ninopereira/skeleton/pcb/DF_mp3_player/Screenshot from 2026-10-21 17-03-53.png

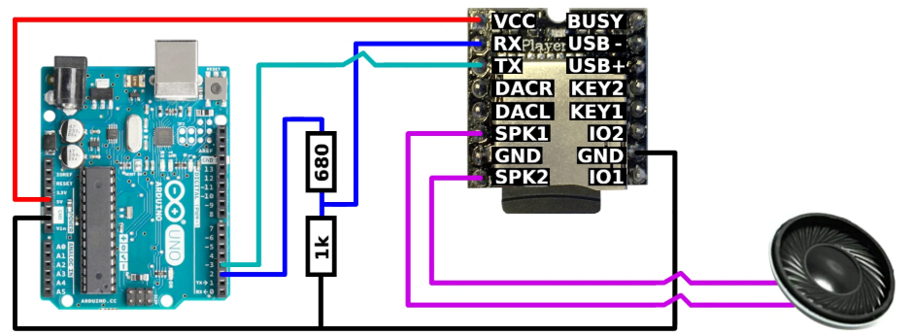
pcb/DF_mp3_player/Screenshot from 2026-10-21 17-03-53.png
