ninopereira/skeleton/docs/DFPlayer_pcb.png

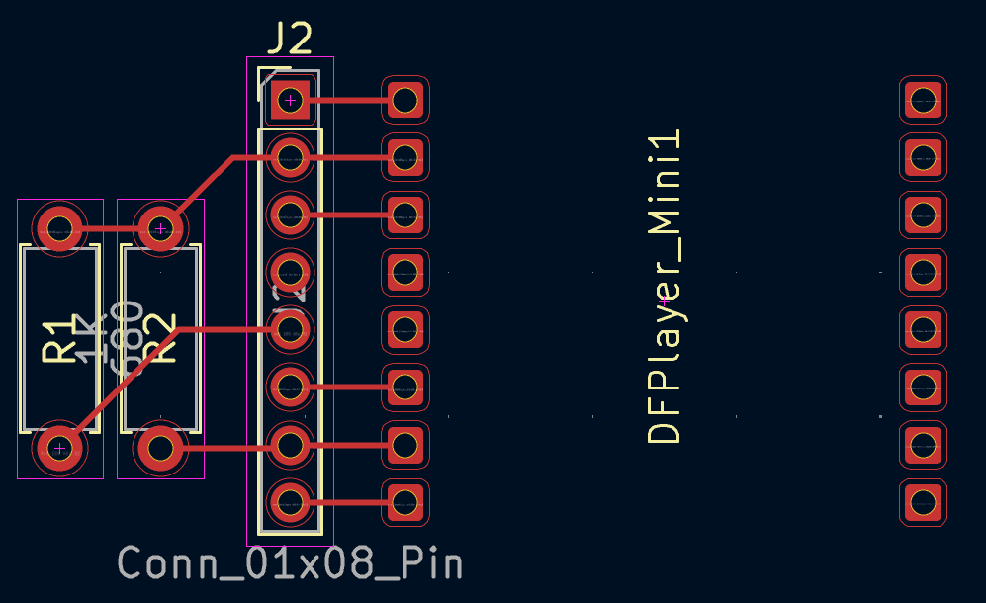
docs/DFPlayer_pcb.png
