ninopereira/skeleton/docs/DFPlayer_schematics.png

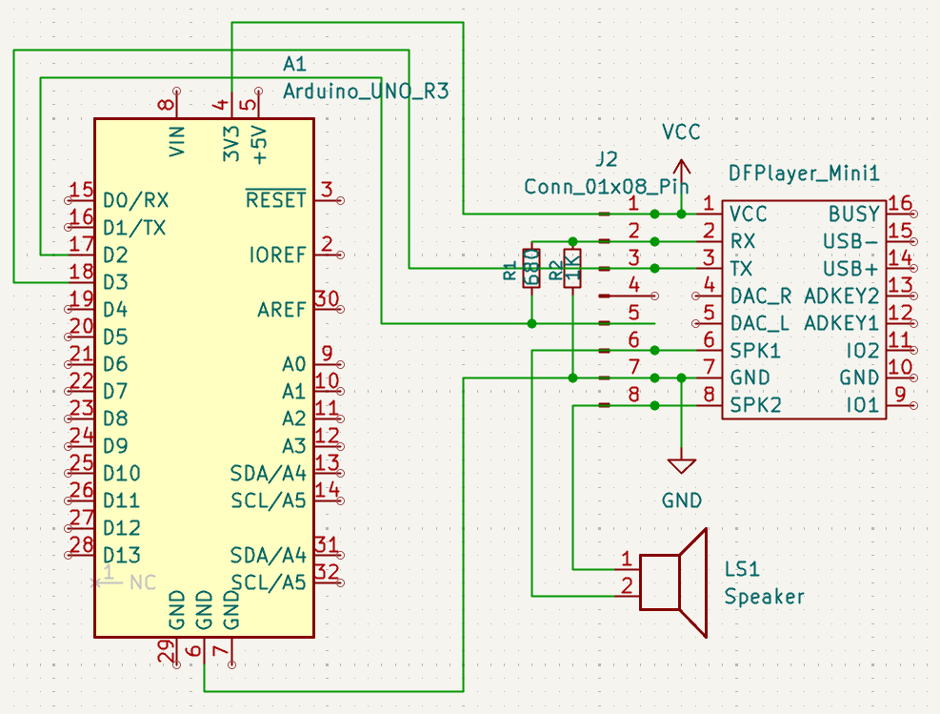
docs/DFPlayer_schematics.png
