ninopereira/skeleton/pcb/DF_mp3_player/Screenshot from 2026-10-21 22-46-34.png

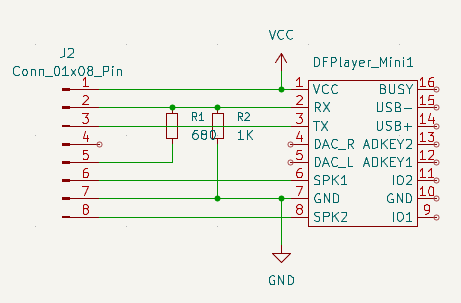
pcb/DF_mp3_player/Screenshot from 2026-10-21 22-46-34.png
