ninopereira/skeleton/pcb/DF_mp3_player/DF_mp3_player.kicad_pcb

## KiCad design pcb/DF_mp3_player/DF_mp3_player.kicad_pcb (2026-10-22)

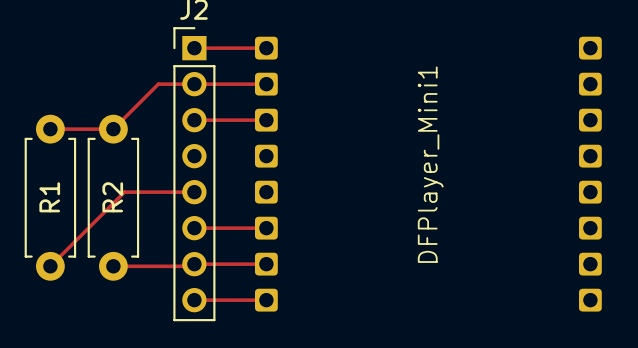
[picture p5: board DF_mp3_player.kicad_pcb from above]

Board: 2 copper layers, 4 parts (0 on the bottom side), 7 nets.

Parts:
DFPlayer_Mini1: DFPlayer_Mini
J2: Conn_01x08_Pin; PinHeader_1x08_P2.00mm_Vertical
R1: 680; R_Axial_DIN0207_L6.3mm_D2.5mm_P7.62mm_Horizontal
R2: 1K; R_Axial_DIN0207_L6.3mm_D2.5mm_P7.62mm_Horizontal

Connections:
GND: DFPlayer_Mini1.7 (GND), J2.7, R2.2
unnamed: DFPlayer_Mini1.2 (RX), J2.2, R1.2, R2.1
unnamed: DFPlayer_Mini1.6 (SPK1), J2.6
unnamed: DFPlayer_Mini1.8 (SPK2), J2.8
unnamed: DFPlayer_Mini1.3 (TX), J2.3
unnamed: J2.5, R1.1
VCC: DFPlayer_Mini1.1 (VCC), J2.1
