ninopereira/skeleton/(commit log)

2026-10-02 Add haunted skeleton sketch for Bot'n Roll ONE A+
    Background music, sonar-triggered talking jaw, random PID-driven arm
    motion and boot beeps.
2026-10-03 Enhance arm movement and interaction logic for haunted skeleton
    - Refactor arm gesture implementation to support staggered movements.
    - Update README with detailed arm motion descriptions.
    - Modify haunted skeleton behavior to synchronize arm movements with voice clips.
    - Add motor test sketch for validating arm motor functionality.
2026-10-03 Refactor arm control logic and enhance encoder feedback handling
2026-10-12 feat: Add voice synthesis script for generating monster voice lines. Add LED control for eyes.
2026-10-12 feat: Update music playback to play next song if sensor interrupted and after voice
2026-10-12 feat: Add wiring diagram for Haunted Skeleton in SVG format
2026-10-12 fix: Update Eye LEDs configuration to reflect series connection and correct resistor value
2026-10-22 Add DFPlayer Mini support and remove motor test sketch
    - Added two PNG screenshots for the DF mp3 player.
    - Created a new fp-lib-table for the DFPlayer library.
    - Removed the motor_test.ino file as it is no longer needed.
    - Introduced mp3_test.ino for testing the DFPlayer Mini functionality, including track playback and serial communication.
    - Updated skeleton.ino to reflect changes in hardware setup and removed unnecessary comments.
2026-10-22 feat: add new voice clips and randomly play one for each interruption
2026-10-22 feat: implement VL53L0X time-of-flight sensor support and refactor presence detection
2026-10-22 feat: update README and add wiring diagram for VL53L0X time-of-flight sensor
2026-10-22 feat: update wiring and documentation for VL53L0X sensor; add serial debug functionality
2026-10-22 feat: enhance music playback handling with queuing and retry logic; improve arm movement easing
2026-10-22 feat: update serial debug settings and improve sensor reading output
2026-10-22 feat: add BUSY pin tracking for DFPlayer Mini; enhance song playback handling
2026-10-22 feat: implement servo detachment after settling to prevent twitching at rest
2026-10-23 feat: increase maximum sweep duration and adjust arm raise/lower times for smoother operation
2026-10-24 fix: adjust arm range of motion
2026-10-25 feat: add isAtRest() method to Arm and Arms classes; update playQueuedSong to check arm status. Uses NeoSWSerial instead of SoftwareSerial library.
